msharp74/MagProfiler/PCB Models/KLDX-0202-A.stp

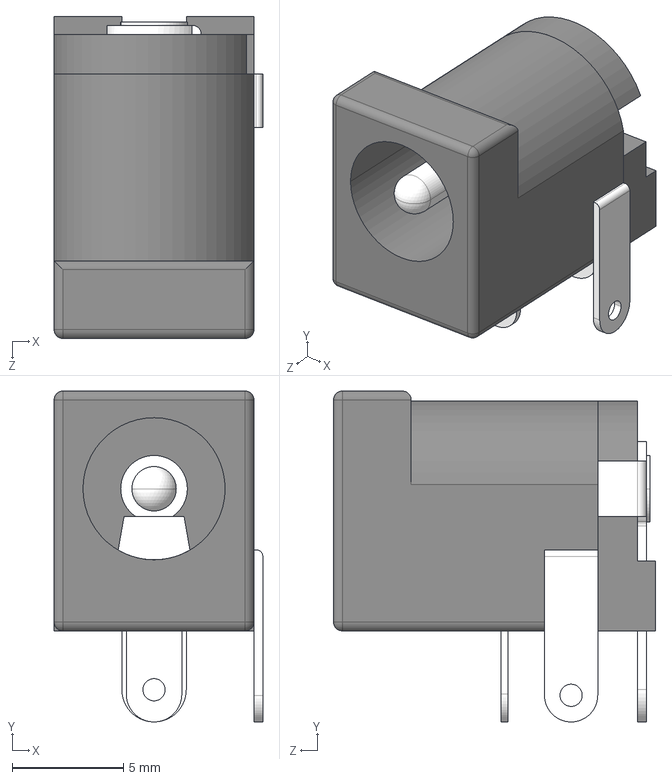
[picture p1: CAD file, 2024-08-11]
PCB Models/KLDX-0202-A.stp
9.40 x 14.9 x 14.5 mm
