msharp74/MagProfiler/PCB Models/629105150521_Download_STP_629105150521_rev1.stp

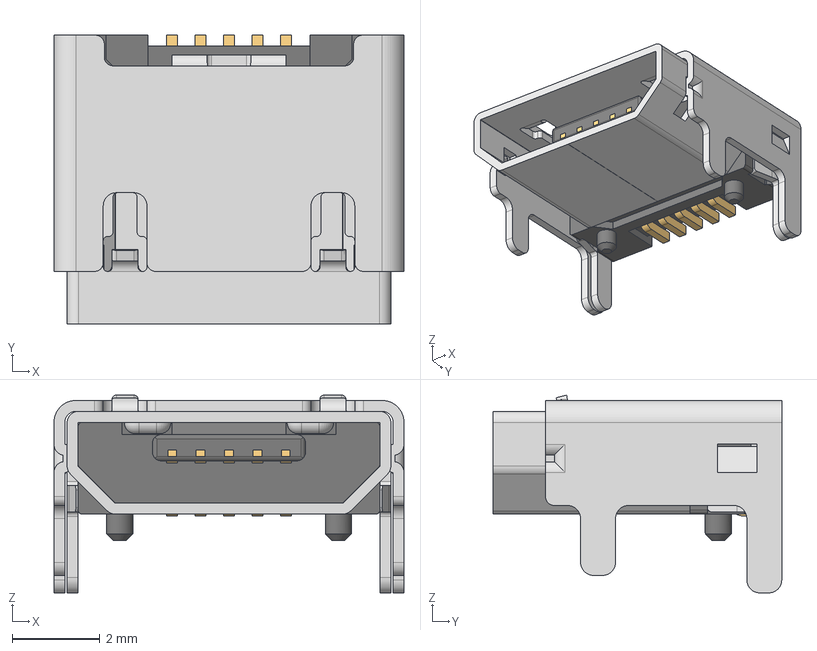
[picture p2: CAD file, 2025-02-13]
PCB Models/629105150521_Download_STP_629105150521_rev1.stp
8.00 x 6.60 x 4.52 mm
629105150521_Housing
629105150521_Pin1 x 4
629105150521_Pin2
629105150521_Shielding2
629105150521_Shielding
