msharp74/MagProfiler/PCB Models/LIB_MLX90393SLW-ABA-011-RE/MLX90393SLW-ABA-011-RE/3D/MLX90393SLW-ABA-011-RE.stp

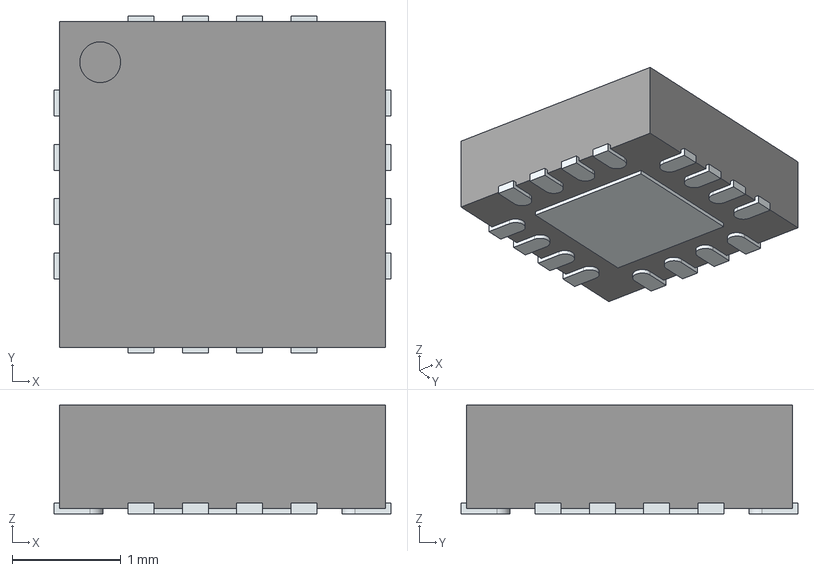
[picture p3: CAD file, 2024-08-11]
PCB Models/LIB_MLX90393SLW-ABA-011-RE/MLX90393SLW-ABA-011-RE/3D/MLX90393SLW-ABA-011-RE.stp
3.10 x 3.10 x 1.00 mm
ThermalPin
PinsArrayLR
PinsArrayTB
