msharp74/MagProfiler/(list of files, cad)

Other CAD files:
PCB Models/LIB_MLX90393SLW-ABA-011-RE/MLX90393SLW-ABA-011-RE/Allegro/qfn50p300x300x100-17n-d.psm
PCB Models/LIB_MLX90393SLW-ABA-011-RE/MLX90393SLW-ABA-011-RE/DEHDL/mlx90393slw_aba_011_re/chips/chips.prt
