msharp74/MagProfiler/Magnetic_field_profiler/Magnetic_field_profiler.kicad_pcb

## KiCad design Magnetic_field_profiler/Magnetic_field_profiler.kicad_pcb (2025-02-13)

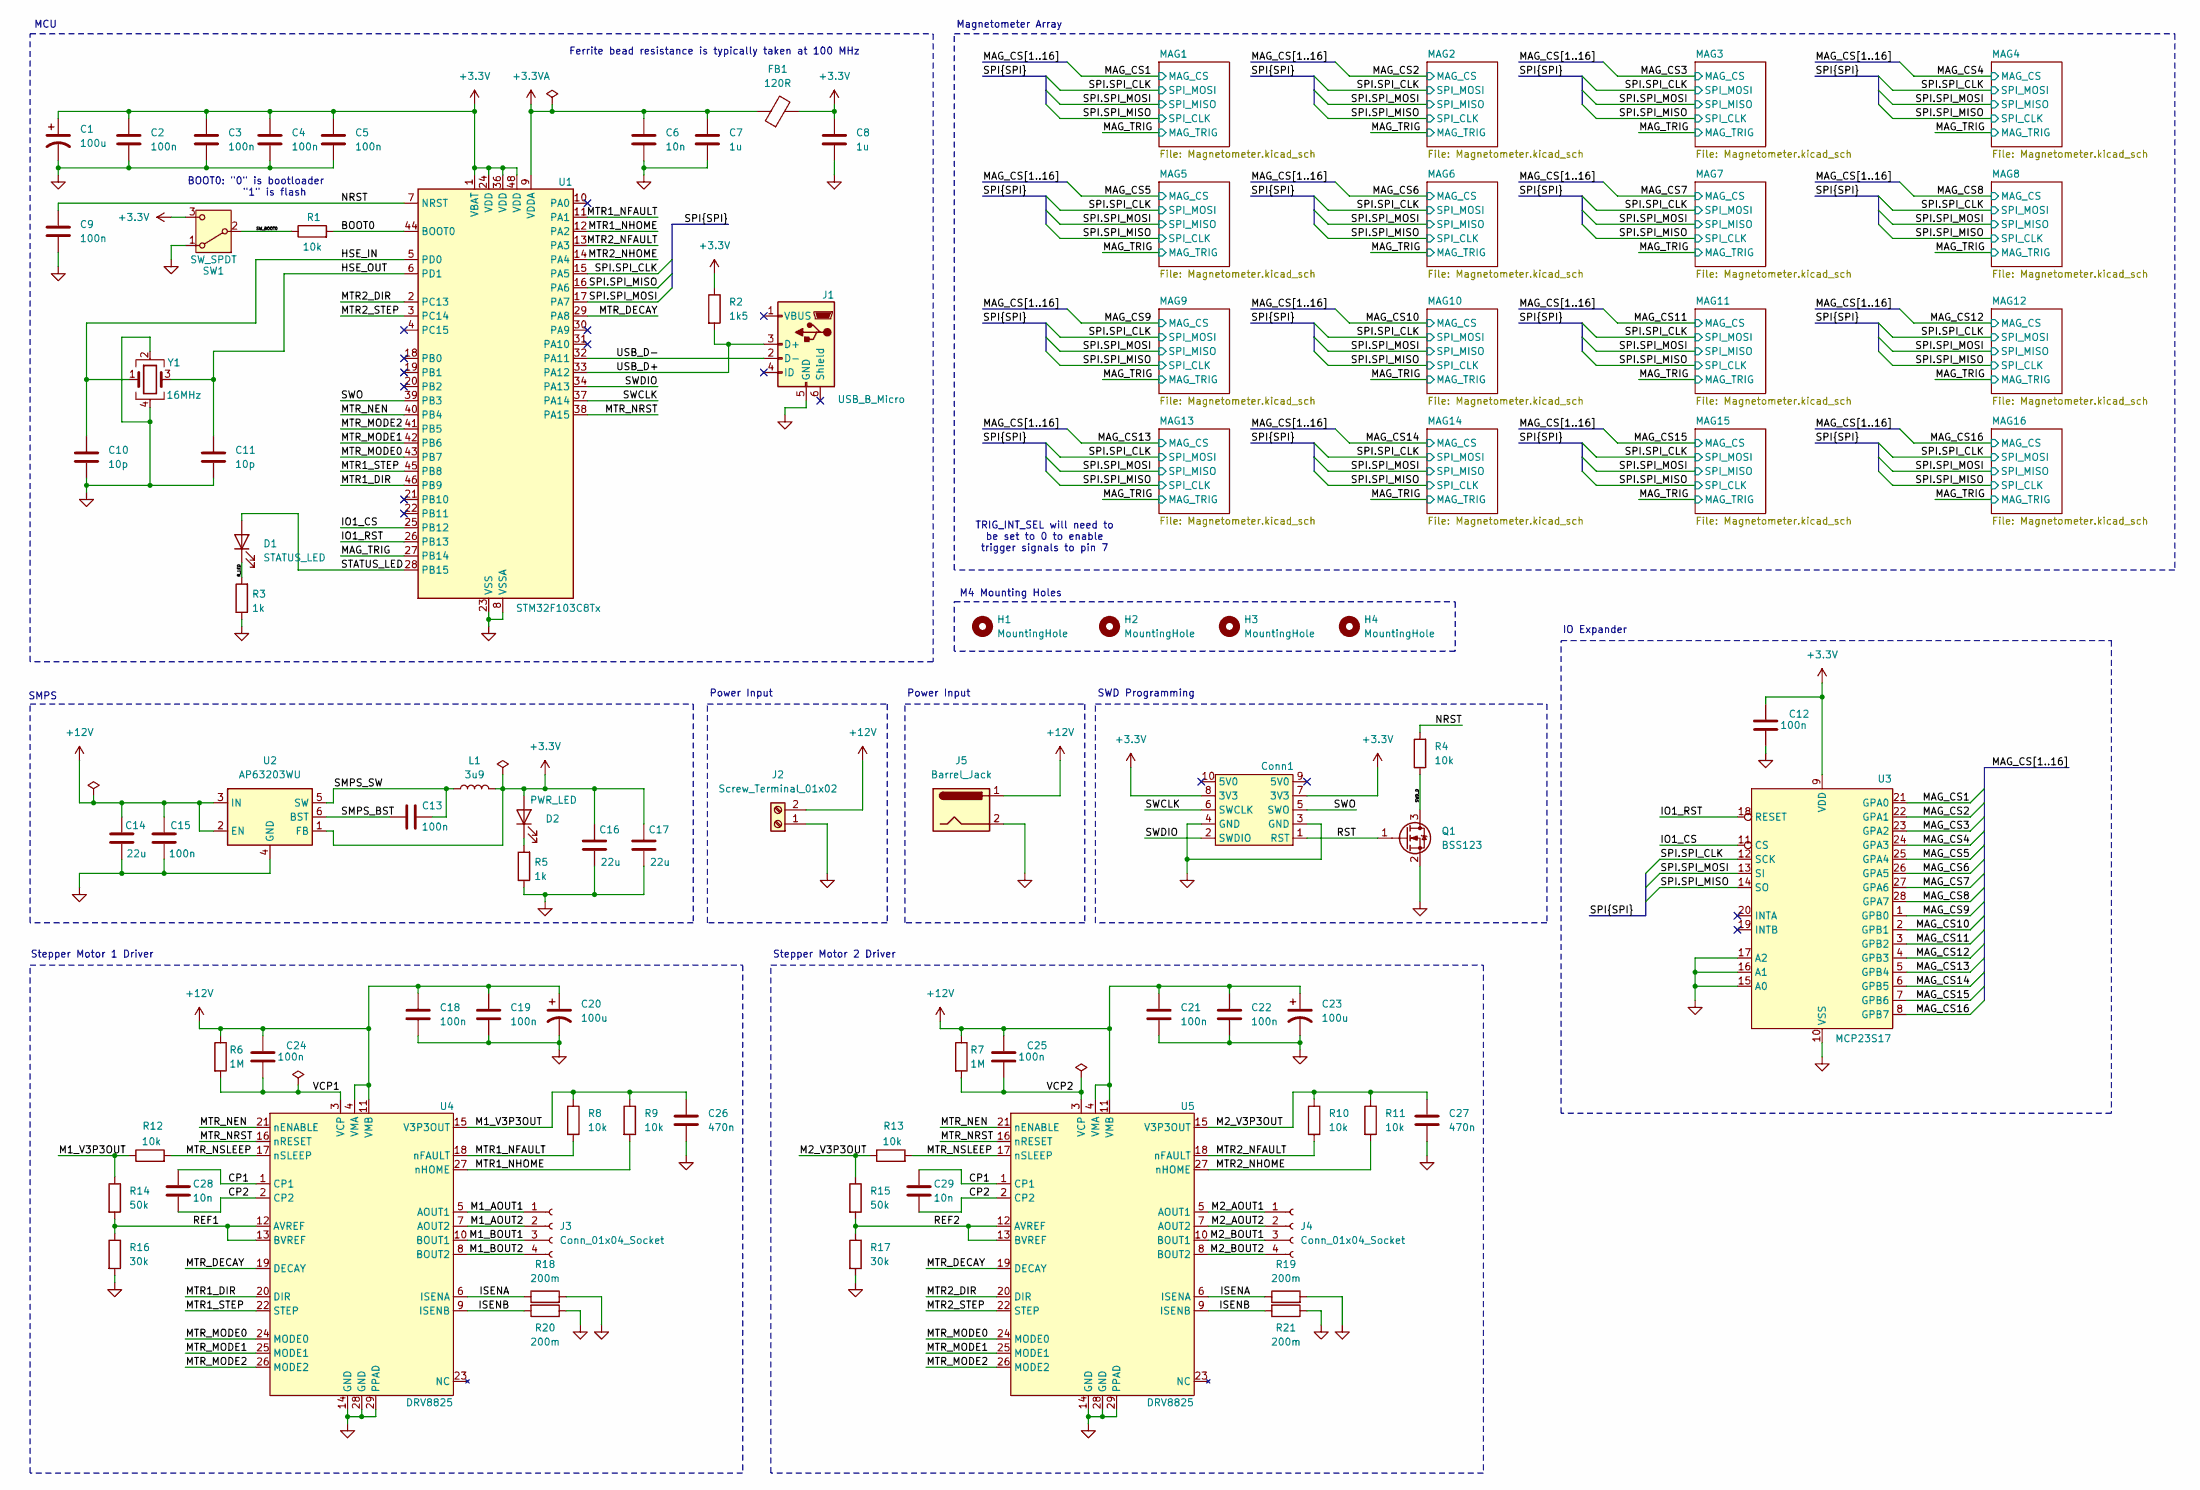
[picture p5: schematic Magnetic_field_profiler.kicad_sch]

Parts:
C1, C20, C23: 100u; CP_Radial_D5.0mm_P2.00mm; Manufacturer Part Number 16ZLH100MEFC5X11
C2, C3, C4, C5, C9, C12, C13, C15, C18, C19, C21, C22, C24, C25: 100n; C_0201_0603Metric; Manufacturer Part Number GRM033C81E104KE14D
C6, C28, C29: 10n; C_0201_0603Metric; Manufacturer Part Number GRM033R61E103KA12D
C7, C8: 1u; C_0603_1608Metric; Manufacturer Part Number CC0603KRX5R8BB105
C10, C11: 10p; C_0402_1005Metric; Manufacturer Part Number GRM1555C1H100FA01D
C14, C16, C17: 22u; C_1206_3216Metric; Manufacturer Part Number CL31A226MOCLNNC
C26, C27: 470n; C_0402_1005Metric; Manufacturer Part Number CL21B474KAFNNNG
Conn1: Tag-Connect_TC2050-IDC-FP_2x05_P1.27mm_Vertical
D1: STATUS_LED; LED_0805_2012Metric; Manufacturer Part Number 150080VS75000
D2: PWR_LED; LED_0805_2012Metric; Manufacturer Part Number 150080RS75000
FB1: 120R; L_0805_2012Metric; Manufacturer Part Number BLM18KG121TN1D
H1, H2, H3, H4: MountingHole; MountingHole_3.2mm_M3
J1: USB_B_Micro; USB_Micro-B_Wuerth_629105150521; Manufacturer Part Number 629105150521
J2: Screw_Terminal_01x02; TerminalBlock_Phoenix_MKDS-1,5-2_1x02_P5.00mm_Horizontal; Manufacturer Part Number 1715022
J3, J4: Conn_01x04_Socket; JST_PH_S4B-PH-K_1x04_P2.00mm_Horizontal; Manufacturer Part Number S4B-PH-K-S
J5: Barrel_Jack; BarrelJack_Wuerth_6941xx301002; Manufacturer Part Number 694108301002
L1: 3u9; L_Abracon_ASPI-3012S; Manufacturer Part Number ASPI-3012S-3R9N-T
Q1: BSS123; SOT-23; Manufacturer Part Number BSS123-7-F
R1, R4, R8, R9, R10, R11, R12, R13: 10k; R_0805_2012Metric; Manufacturer Part Number RMCF0805JT10K0
R2: 1k5; R_0402_1005Metric; Manufacturer Part Number RC0805JR-071K5L
R3, R5: 1k; R_0402_1005Metric; Manufacturer Part Number RC0805FR-071KL
R6, R7: 1M; R_0402_1005Metric; Manufacturer Part Number CRGCQ0402J1M0
R14, R15: 50k; R_0402_1005Metric; Manufacturer Part Number CRCW040250K0FKED
R16, R17: 30k; R_0402_1005Metric; Manufacturer Part Number RC0402FR-0730KL
R18, R19, R20, R21: 200m; R_1206_3216Metric; Manufacturer Part Number CSR1206FKR200
SW1: SW_SPDT; SW_SPDT_PCM12; Manufacturer Part Number B3F-1000
U1: STM32F103C8Tx; LQFP-48_7x7mm_P0.5mm; Manufacturer Part Number STM32F103C8T6TR
U2: AP63203WU; TSOT-23-6; Manufacturer Part Number AP63203WU-7
U3: MCP23S17; SSOP-28_5.3x10.2mm_P0.65mm; Manufacturer Part Number MCP23S17T-E/SS
U4, U5: DRV8825; TSSOP-28-1EP_4.4x9.7mm_P0.65mm; Manufacturer Part Number DRV8825PWPR
Y1: 16MHz; Crystal_SMD_3225-4Pin_3.2x2.5mm

Connections:
+3.3V: C1.1, C2.1, C3.1, C4.1, C5.1, C8.1, C12.1, C16.1, C17.1, Conn1.7 (3V3), Conn1.8 (3V3), D2.2 (A), FB1.2, L1.2, R2.1, SW1.3 (C), U1.1 (VBAT), U1.24 (VDD), U1.36 (VDD), U1.48 (VDD), U2.1 (FB), U3.9 (VDD); also elsewhere on the board
+3.3VA: C6.1, C7.1, FB1.1, U1.9 (VDDA)
+12V: C14.2, C15.1, C18.1, C19.1, C20.1, C21.1, C22.1, C23.1, C24.1, C25.1, J2.2, J5.1, R6.1, R7.1, U2.2 (EN), U2.3 (IN), U4.4 (VMA), U4.11 (VMB), U5.4 (VMA), U5.11 (VMB)
/BOOT0: R1.2, U1.44 (BOOT0)
/CP1: C28.1, C29.1, U4.1 (CP1), U5.1 (CP1)
/CP2: C28.2, C29.2, U4.2 (CP2), U5.2 (CP2)
/HSE_IN: C10.1, U1.5 (PD0), Y1.1
/HSE_OUT: C11.1, U1.6 (PD1), Y1.3
/IO1_CS: U1.25 (PB12), U3.11 (CS)
/IO1_RST: U1.26 (PB13), U3.18 (RESET)
/ISENA: R18.1, R19.1, U4.6 (ISENA), U5.6 (ISENA)
/ISENB: R20.2, R21.2, U4.9 (ISENB), U5.9 (ISENB)
/M1_AOUT1: J3.1, U4.5 (AOUT1)
/M1_AOUT2: J3.2, U4.7 (AOUT2)
/M1_BOUT1: J3.3, U4.10 (BOUT1)
/M1_BOUT2: J3.4, U4.8 (BOUT2)
/M1_V3P3OUT: C26.1, R8.1, R9.1, R12.1, R14.1, U4.15 (V3P3OUT)
/M2_AOUT1: J4.1, U5.5 (AOUT1)
/M2_AOUT2: J4.2, U5.7 (AOUT2)
/M2_BOUT1: J4.3, U5.10 (BOUT1)
/M2_BOUT2: J4.4, U5.8 (BOUT2)
/M2_V3P3OUT: C27.1, R10.1, R11.1, R13.1, R15.1, U5.15 (V3P3OUT)
/MAG_CS1: U3.21 (GPA0); also elsewhere on the board
/MAG_CS2: U3.22 (GPA1); also elsewhere on the board
/MAG_CS3: U3.23 (GPA2); also elsewhere on the board
/MAG_CS4: U3.24 (GPA3); also elsewhere on the board
/MAG_CS5: U3.25 (GPA4); also elsewhere on the board
/MAG_CS6: U3.26 (GPA5); also elsewhere on the board
/MAG_CS7: U3.27 (GPA6); also elsewhere on the board
/MAG_CS8: U3.28 (GPA7); also elsewhere on the board
/MAG_CS9: U3.1 (GPB0); also elsewhere on the board
/MAG_CS10: U3.2 (GPB1); also elsewhere on the board
/MAG_CS11: U3.3 (GPB2); also elsewhere on the board
/MAG_CS12: U3.4 (GPB3); also elsewhere on the board
/MAG_CS13: U3.5 (GPB4); also elsewhere on the board
/MAG_CS14: U3.6 (GPB5); also elsewhere on the board
/MAG_CS15: U3.7 (GPB6); also elsewhere on the board
/MAG_CS16: U3.8 (GPB7); also elsewhere on the board
/MAG_TRIG: U1.27 (PB14); also elsewhere on the board
/MTR1_DIR: U1.46 (PB9), U4.20 (DIR)
/MTR1_NFAULT: R8.2, U1.11 (PA1), U4.18 (nFAULT)
/MTR1_NHOME: R9.2, U1.12 (PA2), U4.27 (nHOME)
/MTR1_STEP: U1.45 (PB8), U4.22 (STEP)
/MTR2_DIR: U1.2 (PC13), U5.20 (DIR)
/MTR2_NFAULT: R10.2, U1.13 (PA3), U5.18 (nFAULT)
/MTR2_NHOME: R11.2, U1.14 (PA4), U5.27 (nHOME)
/MTR2_STEP: U1.3 (PC14), U5.22 (STEP)
/MTR_DECAY: U1.29 (PA8), U4.19 (DECAY), U5.19 (DECAY)
/MTR_MODE0: U1.43 (PB7), U4.24 (MODE0), U5.24 (MODE0)
/MTR_MODE1: U1.42 (PB6), U4.25 (MODE1), U5.25 (MODE1)
/MTR_MODE2: U1.41 (PB5), U4.26 (MODE2), U5.26 (MODE2)
/MTR_NEN: U1.40 (PB4), U4.21 (nENABLE), U5.21 (nENABLE)
/MTR_NRST: U1.38 (PA15), U4.16 (nRESET), U5.16 (nRESET)
/MTR_NSLEEP: R12.2, R13.2, U4.17 (nSLEEP), U5.17 (nSLEEP)
/NRST: C9.1, R4.2, U1.7 (NRST)
/REF1: R14.2, R16.1, U4.12 (AVREF), U4.13 (BVREF)
/REF2: R15.2, R17.1, U5.12 (AVREF), U5.13 (BVREF)
/RST: Conn1.1 (RST), Q1.1 (G)
/R_LED: D1.1 (K), R3.2
/SMPS_BST: C13.1, U2.6 (BST)
/SMPS_SW: C13.2, L1.1, U2.5 (SW)
/SPI.SPI_CLK: U1.15 (PA5), U3.12 (SCK); also elsewhere on the board
/SPI.SPI_MISO: U1.16 (PA6), U3.14 (SO); also elsewhere on the board
/SPI.SPI_MOSI: U1.17 (PA7), U3.13 (SI); also elsewhere on the board
/STATUS_LED: D1.2 (A), U1.28 (PB15)
/SWCLK: Conn1.6 (SWCLK), U1.37 (PA14)
/SWDIO: Conn1.2 (SWDIO), U1.34 (PA13)
/SWD_D: Q1.3 (D), R4.1
/SWO: Conn1.5 (SWO), U1.39 (PB3)
/SW_BOOT0: R1.1, SW1.2 (B)
/USB_D+: J1.3 (D+), R2.2, U1.33 (PA12)
/USB_D-: J1.2 (D-), U1.32 (PA11)
/VCP1: C24.2, R6.2, U4.3 (VCP)
/VCP2: C25.2, R7.2, U5.3 (VCP)
GND: C1.2, C2.2, C3.2, C4.2, C5.2, C6.2, C7.2, C8.2, C9.2, C10.2, C11.2, C12.2, C14.1, C15.2, C16.2, C17.2, C18.2, C19.2, C20.2, C21.2, C22.2, C23.2, C26.2, C27.2, Conn1.3 (GND), Conn1.4 (GND), J1.5 (GND), J2.1, J5.2, Q1.2 (S), R3.1, R5.1, R16.2, R17.2, R18.2, R19.2, R20.1, R21.1, SW1.1 (A), U1.8 (VSSA), U1.23 (VSS), U1.35 (VSS), U1.47 (VSS), U2.4 (GND), U3.10 (VSS), U3.15 (A0), U3.16 (A1), U3.17 (A2), U4.14 (GND), U4.28 (GND), U4.29 (PPAD), U5.14 (GND), U5.28 (GND), U5.29 (PPAD), Y1.2, Y1.4; also elsewhere on the board
unnamed: D2.1 (K), R5.2

Notes on the sheet:
TRIG_INT_SEL will need to be set to 0 to enable trigger signals to pin 7
SMPS
Magnetometer Array
BOOT0: "0" is bootloader "1" is flash
MCU
Stepper Motor 1 Driver
Ferrite bead resistance is typically taken at 100 MHz
SWD Programming
Power Input
M4 Mounting Holes
Stepper Motor 2 Driver
IO Expander

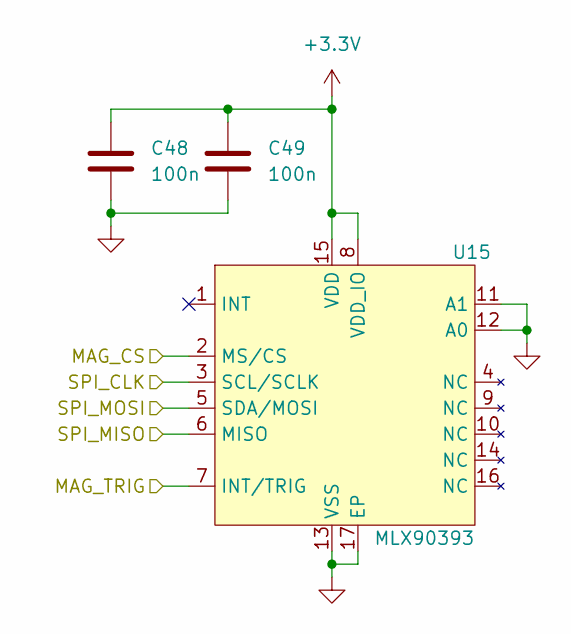
[picture p6: schematic Magnetometer.kicad_sch]

Parts:
C48, C49: 100n; C_0201_0603Metric; Manufacturer Part Number GRM033C81E104KE14D
U15: MLX90393; QFN-16-1EP_3x3mm_P0.5mm_EP1.75x1.75mm_ThermalVias; Manufacturer Part Number MLX90393SLW-ABA-011-RE

Connections:
+3.3V: C48.1, C49.1, U15.8 (VDD_IO), U15.15 (VDD); also elsewhere on the board
/MAG_CS10: U15.2 (MS/CS); also elsewhere on the board
/MAG_TRIG: U15.7 (INT/TRIG); also elsewhere on the board
/SPI.SPI_CLK: U15.5 (SDA/MOSI); also elsewhere on the board
/SPI.SPI_MISO: U15.3 (SCL/SCLK); also elsewhere on the board
/SPI.SPI_MOSI: U15.6 (MISO); also elsewhere on the board
GND: C48.2, C49.2, U15.11 (A1), U15.12 (A0), U15.13 (VSS), U15.17 (EP); also elsewhere on the board

Parts of its further copies:
C30, C31, C32, C33, C34, C35, C36, C37, C38, C39, C40, C41, C42, C43, C44, C45, C46, C47, C50, C51, C52, C53, C54, C55, C56, C57, C58, C59, C60, C61: 100n; C_0201_0603Metric; Manufacturer Part Number GRM033C81E104KE14D
U6, U7, U8, U9, U10, U11, U12, U13, U14, U16, U17, U18, U19, U20, U21: MLX90393; QFN-16-1EP_3x3mm_P0.5mm_EP1.75x1.75mm_ThermalVias; Manufacturer Part Number MLX90393SLW-ABA-011-RE

Connections of its further copies:
+3.3V: C30.1, C31.1, C32.1, C33.1, C34.1, C35.1, C36.1, C37.1, C38.1, C39.1, C40.1, C41.1, C42.1, C43.1, C44.1, C45.1, C46.1, C47.1, C50.1, C51.1, C52.1, C53.1, C54.1, C55.1, C56.1, C57.1, C58.1, C59.1, C60.1, C61.1, U6.8 (VDD_IO), U6.15 (VDD), U7.8 (VDD_IO), U7.15 (VDD), U8.8 (VDD_IO), U8.15 (VDD), U9.8 (VDD_IO), U9.15 (VDD), U10.8 (VDD_IO), U10.15 (VDD), U11.8 (VDD_IO), U11.15 (VDD), U12.8 (VDD_IO), U12.15 (VDD), U13.8 (VDD_IO), U13.15 (VDD), U14.8 (VDD_IO), U14.15 (VDD), U16.8 (VDD_IO), U16.15 (VDD), U17.8 (VDD_IO), U17.15 (VDD), U18.8 (VDD_IO), U18.15 (VDD), U19.8 (VDD_IO), U19.15 (VDD), U20.8 (VDD_IO), U20.15 (VDD), U21.8 (VDD_IO), U21.15 (VDD); also elsewhere on the board
/MAG_CS1: U6.2 (MS/CS); also elsewhere on the board
/MAG_CS2: U7.2 (MS/CS); also elsewhere on the board
/MAG_CS3: U8.2 (MS/CS); also elsewhere on the board
/MAG_CS4: U9.2 (MS/CS); also elsewhere on the board
/MAG_CS5: U10.2 (MS/CS); also elsewhere on the board
/MAG_CS6: U11.2 (MS/CS); also elsewhere on the board
/MAG_CS7: U12.2 (MS/CS); also elsewhere on the board
/MAG_CS8: U13.2 (MS/CS); also elsewhere on the board
/MAG_CS9: U14.2 (MS/CS); also elsewhere on the board
/MAG_CS11: U16.2 (MS/CS); also elsewhere on the board
/MAG_CS12: U17.2 (MS/CS); also elsewhere on the board
/MAG_CS13: U18.2 (MS/CS); also elsewhere on the board
/MAG_CS14: U19.2 (MS/CS); also elsewhere on the board
/MAG_CS15: U20.2 (MS/CS); also elsewhere on the board
/MAG_CS16: U21.2 (MS/CS); also elsewhere on the board
/MAG_TRIG: U6.7 (INT/TRIG), U7.7 (INT/TRIG), U8.7 (INT/TRIG), U9.7 (INT/TRIG), U10.7 (INT/TRIG), U11.7 (INT/TRIG), U12.7 (INT/TRIG), U13.7 (INT/TRIG), U14.7 (INT/TRIG), U16.7 (INT/TRIG), U17.7 (INT/TRIG), U18.7 (INT/TRIG), U19.7 (INT/TRIG), U20.7 (INT/TRIG), U21.7 (INT/TRIG); also elsewhere on the board
/SPI.SPI_CLK: U6.5 (SDA/MOSI), U7.5 (SDA/MOSI), U8.5 (SDA/MOSI), U9.5 (SDA/MOSI), U10.5 (SDA/MOSI), U11.5 (SDA/MOSI), U12.5 (SDA/MOSI), U13.5 (SDA/MOSI), U14.5 (SDA/MOSI), U16.5 (SDA/MOSI), U17.5 (SDA/MOSI), U18.5 (SDA/MOSI), U19.5 (SDA/MOSI), U20.5 (SDA/MOSI), U21.5 (SDA/MOSI); also elsewhere on the board
/SPI.SPI_MISO: U6.3 (SCL/SCLK), U7.3 (SCL/SCLK), U8.3 (SCL/SCLK), U9.3 (SCL/SCLK), U10.3 (SCL/SCLK), U11.3 (SCL/SCLK), U12.3 (SCL/SCLK), U13.3 (SCL/SCLK), U14.3 (SCL/SCLK), U16.3 (SCL/SCLK), U17.3 (SCL/SCLK), U18.3 (SCL/SCLK), U19.3 (SCL/SCLK), U20.3 (SCL/SCLK), U21.3 (SCL/SCLK); also elsewhere on the board
/SPI.SPI_MOSI: U6.6 (MISO), U7.6 (MISO), U8.6 (MISO), U9.6 (MISO), U10.6 (MISO), U11.6 (MISO), U12.6 (MISO), U13.6 (MISO), U14.6 (MISO), U16.6 (MISO), U17.6 (MISO), U18.6 (MISO), U19.6 (MISO), U20.6 (MISO), U21.6 (MISO); also elsewhere on the board
GND: C30.2, C31.2, C32.2, C33.2, C34.2, C35.2, C36.2, C37.2, C38.2, C39.2, C40.2, C41.2, C42.2, C43.2, C44.2, C45.2, C46.2, C47.2, C50.2, C51.2, C52.2, C53.2, C54.2, C55.2, C56.2, C57.2, C58.2, C59.2, C60.2, C61.2, U6.11 (A1), U6.12 (A0), U6.13 (VSS), U6.17 (EP), U7.11 (A1), U7.12 (A0), U7.13 (VSS), U7.17 (EP), U8.11 (A1), U8.12 (A0), U8.13 (VSS), U8.17 (EP), U9.11 (A1), U9.12 (A0), U9.13 (VSS), U9.17 (EP), U10.11 (A1), U10.12 (A0), U10.13 (VSS), U10.17 (EP), U11.11 (A1), U11.12 (A0), U11.13 (VSS), U11.17 (EP), U12.11 (A1), U12.12 (A0), U12.13 (VSS), U12.17 (EP), U13.11 (A1), U13.12 (A0), U13.13 (VSS), U13.17 (EP), U14.11 (A1), U14.12 (A0), U14.13 (VSS), U14.17 (EP), U16.11 (A1), U16.12 (A0), U16.13 (VSS), U16.17 (EP), U17.11 (A1), U17.12 (A0), U17.13 (VSS), U17.17 (EP), U18.11 (A1), U18.12 (A0), U18.13 (VSS), U18.17 (EP), U19.11 (A1), U19.12 (A0), U19.13 (VSS), U19.17 (EP), U20.11 (A1), U20.12 (A0), U20.13 (VSS), U20.17 (EP), U21.11 (A1), U21.12 (A0), U21.13 (VSS), U21.17 (EP); also elsewhere on the board

Board: 4 copper layers, 120 parts (0 on the bottom side), 76 nets, no tracks yet.
