msharp74/MagProfiler/SW/Magnetic Field Profiler.ioc

Mcu.UserName=STM32F103C8Tx
PA1.GPIO_Label=MTR1_NFAULT
PA1.Signal=GPIO_Input
PA11.Signal=USB_DM
PA12.Signal=USB_DP
PA13.Signal=SYS_JTMS-SWDIO
PA14.Signal=SYS_JTCK-SWCLK
PA15.GPIO_Label=MTR_NRST
PA15.Signal=GPIO_Output
PA2.GPIO_Label=MTR1_NHOME
PA2.Signal=GPIO_Input
PA3.GPIO_Label=MTR2_NFAULT
PA3.Signal=GPIO_Input
PA4.GPIO_Label=MTR2_NHOME
PA4.Signal=GPIO_Input
PA5.Signal=SPI1_SCK
PA6.Signal=SPI1_MISO
PA7.Signal=SPI1_MOSI
PA8.GPIO_Label=MTR_DECAY
PA8.Signal=GPIO_Output
PB12.GPIO_Label=IO_CS
PB12.Signal=GPIO_Output
PB13.GPIO_Label=IO_RST
PB13.Signal=GPIO_Output
PB14.GPIO_Label=MAG_TRIG
PB14.Signal=GPIO_Output
PB15.GPIO_Label=STATUS_LED
PB15.Signal=GPIO_Output
PB3.Signal=SYS_JTDO-TRACESWO
PB4.GPIO_Label=MTR_NEN
PB4.Signal=GPIO_Output
PB5.GPIO_Label=MTR_MODE2
PB5.Signal=GPIO_Output
PB6.GPIO_Label=MTR_MODE1
PB6.Signal=GPIO_Output
PB7.GPIO_Label=MTR_MODE0
PB7.Signal=GPIO_Output
PB8.GPIO_Label=MTR1_STEP
PB8.Signal=GPIO_Output
PB9.GPIO_Label=MTR1_DIR
PB9.Signal=GPIO_Output
PC13-TAMPER-RTC.GPIO_Label=MTR2_DIR
PC13-TAMPER-RTC.Signal=GPIO_Output
PC14-OSC32_IN.GPIO_Label=MTR2_STEP
PC14-OSC32_IN.Signal=GPIO_Output
PD0-OSC_IN.Signal=RCC_OSC_IN
PD1-OSC_OUT.Signal=RCC_OSC_OUT
