msharp74/MagProfiler/(commit log)

2024-08-12 SMPS Added, Edge Cuts Modified
    [Magnetic_field_profiler.kicad_pcb, Magnetic_field_profiler.kicad_sch]
2024-08-14 Added SMPS and removed LDO
    [Magnetic_field_profiler.kicad_sch]
2024-08-15 Edge cuts updated
    [Magnetic_field_profiler.kicad_pcb, Magnetic_field_profiler.kicad_sch]
2024-08-17 PCB Updates and Second Motor Support
    [Magnetic_field_profiler.kicad_pcb, Magnetic_field_profiler.kicad_sch, Magnetometer.kicad_sch]
2024-10-08 Symbol Properties Edits
    [Magnetic_field_profiler.kicad_sch, Magnetometer.kicad_sch]
2024-10-09 MCU I2C configuration
    [Magnetic_field_profiler.kicad_sch]
2024-10-14 Footprint creation
2024-10-15 IO expander wchematic and footprint updated. Adjusted the schematic representation of the magnetometer array.
    [Magnetic_field_profiler.kicad_sch, Magnetometer.kicad_sch]
2024-10-16 IO expander connections complete and PCB layout restarted
    [Magnetic_field_profiler.kicad_pcb, Magnetic_field_profiler.kicad_sch, Magnetometer.kicad_sch]
2024-10-17 Swapping MCU IOs and defining netclasses
    [Magnetic_field_profiler.kicad_pcb, Magnetic_field_profiler.kicad_sch]
2024-10-22 Added status LEDs, began updating netclass trace widths
    [Magnetic_field_profiler.kicad_sch]
2024-10-23 BOM Information Update
    [Magnetic_field_profiler.kicad_sch, Magnetometer.kicad_sch]
2024-10-29 Adding part descriptions
    [Magnetic_field_profiler.kicad_sch]
2024-10-31 DC-DC converter rework
    [Magnetic_field_profiler.kicad_sch, Magnetometer.kicad_sch]
2024-11-01 Continued adding component description and sourcing information
    [Magnetic_field_profiler.kicad_sch, Magnetometer.kicad_sch]
2024-11-02 Initial PCB layout
    [Magnetic_field_profiler.kicad_pcb, Magnetic_field_profiler.kicad_sch]
2024-12-19 Arduino Stepper Test Program
2024-12-23 Arduino Initial Commit
2024-12-27 added position tracking for motors
2024-12-29 restructuring carriage object
2025-01-02 finished restructuing motor and carriage classes. fixed incorrect angular positioning
    [DM320T.cpp, DM320T.h, dualLeadscrewCarriage.cpp, dualLeadscrewCarriage.h, main.cpp]
2025-01-14 adding functionality to move carriage to specific position
2025-02-11 Added control over motor controller decay line
    [Magnetic_field_profiler.kicad_sch]
2025-02-12 PCB Review
    [Magnetic_field_profiler.kicad_sch]
2025-02-13 Initial component placement
    [629105150521_Download_STP_629105150521_rev1.stp, 694108301002 (rev1).stp, Magnetic_field_profiler.kicad_pcb, Magnetic_field_profiler.kicad_sch]
